LGH1996/biye/plantuml/测距.png

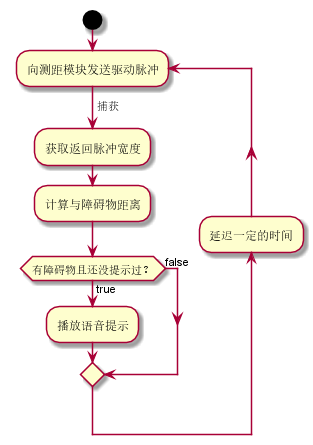
plantuml/测距.png
