LGH1996/biye/(list of files, cad)

Other CAD files:
Objects/main.obj
Objects/STARTUP.obj
Objects/programer.obj
Objects/progrem_1.obj
Objects/qqqqqqqqqq.obj
Objects/led.obj
Objects/music.obj
Objects/ceju.obj
Objects/test.obj
Objects/light.obj
