LGH1996/biye/(list of files, drawings)

Other design files:
0413.DSN
0503.DSN
New Project.pdsprj
